kautickv/Closed-Loop-Liquid-cooling-system/(commit log)

2021-06-23 Added Wifi Arduino Code
    An ESP8266 WIFI Module is connected to the Arduino Uno board. This code will initialise the WIFI module and connect the Arduino Uno board to the internet. The code will also initialise the I2C communication protocol and use it to verify id the Sensor Arduino board is connected.
2021-06-23 Sensor Arduino Code Added
    This code will initialise the IO Pins on the Sensor Arduino Uno board, initialise the I2C communication with the WIFI Arduino board ,read information from the sensors and push them to the Thingspeak database.
